ekorudiawan/KIWI-Final-Project/Dokumen KIWI FINAL/KIWI_FINAL_1.00.docx

[ KIWI FINAL AUTO PASTING NAMEPLATE USER & MAINTENANCE MANUAL]

# INDEX

# INTRODUCTION

The aim of this manual is to supply specification about the correct use of electrical drawing, schematic, flowchart and program.

# REFERENCE DATA

Costumer : SCHENEIDER ELECTRIC MANUFACTURING BATAM

Address : BATAMINDO INDUSTRIAL PARK LOT 4 MUKA KUNING

Machine Name : KIWI FINAL AUTO PASTING NAMEPLATE

Last Release : 1. Manual : KIWI_FINAL_1.00

2. Document Support : Electric_SCH

: Input_PLC

: Output_PLC

: Panel_Box

# WARNING FOR OPERATION SAFETY

The machine is equipped with automation test system. If there is any automation or spesific hardware make reference to the related chapter of this manual.

Don’t use product or machine programs different from the ones listed on Product Reference.

Don’t use machine if all parts have not been properly installed. See layout and schematic diagram inside this manual.

If you are doubt or disagree with the application, please press “Emergency Button” then report to maintenace.

# WARNING FOR MACHINE SAFETY

Before start the machine, please check all ecectrical supply and air supply is on. Wait until “Yellow Lamp” turn on. It’s indicate that machine ready to operate. If something problem, normally HMI panel will inform you what is the problem. But, if it’s not work, you can do this action.

- Push “Emergency Button” in HMI Panel Box.
- Red Lamp will be on, this indicate your machine is problem.
- Remove product from machine if product still on machine.
- Release “Emergency Button” and press “RESET Button” to reset emergency condition.
- Machine ready to operate again by pressing “START Button”
- If this action still not work, please turn off all electrical & air supply then restart the machine or you can report to project engineer or maintenance.

# WARNING FOR ADAPTER SAFETY

The main power input for the machine is single phase 220VAC. When installing the machine make sure that the terminal input power is installed corectly.

# 1. TEST APPLIACTION – OPERATE & USE

  1.1 START UP

After the installation for the incoming power ready with AC 220 V.

1. Switch on the main switch.
2. Switch on all MCB inside panel box.
3. Wait untill “YELLOW Lamp” or “RED Lamp” turn on.
4. Machine ready to use.
  1.2 OPERATE IN AUTOMATIC MODE

Normally automatic mode use for running product. To operate the machine with automatic mode follow this instruction.

1. Your machine already “START UP”, please follow intruction in point 1.1
2. Change “AUTO/MAN Button” to automatic position.
3. Press “START Button” to start machine in automatic mode.
4. “Green Lamp” will turn on, this indicate that your machine running in automatic mode.
5. Open KIWI Application, then scan reference of your product.
6. Insert the product to machine.
7. Nameplate will be print and pasting to product automatically.
8. Don’t put your hand inside the machine when machine still process to assembly or marking product.
9. To stop machine press “STOP Button”.
  1.3 OPERATE IN MANUAL MODE

Manual mode use for checking all condition of sensor and actuator works. With manual mode you can easy to find problem of machine if machine not works. Operate actuator one by one and then check sensor condition in HMI display. To operate in manual mode please follow this instruction.

1. Your machine already “START UP”, please follow intruction in point 1.1
2. Change “AUTO/MAN Button” to manual position.
3. Press “Manual Tab” in HMI panel.
4. To operate the cylinder or actuator you can press cylinder button one by one in HMI panel.
5. To monitor sensor and other input, you can press menu “I/O Monitor” in HMI panel.
  1.4 TROUBLESHOOTING

1.3.1 PLC

- PLC need supply 220 VAC and common 24V DC (if use PNP wiring), 0V DC (if use NPN wiring)
- Verify if mode operation of PLC is RUN mode.
- If PLC in STOP mode, please change to RUN with Serial cable and PLC software.
- If PLC in ERROR mode, please restartup the machine, refer to point 1.1

1.3.2 HMI Display

- HMI display need 24V DC supply, this supply connected to main power supply inside main panel machine. If HMI display not turn on, please check this connection cable.
- To communicate with PLC, HMI use ethernet cable. If HMI display not working or showing connection error in display, please check connection of this cable.

1.3.3 Sensor

Please see source document of sensor.

# 2. MACHINE APPLICATION – GENERAL INFORMATION

  2.1 Flowchart Machine Process

# 3. PROJECT DOCUMENT

  3.1 Sparepart

No | Main Panel
| Part Name | Spec | Qty | Used
1 | MCB | 2 pole 15A | 1 unit | Supply PLC
2 | MCB | 2 pole 15A | 1 unit | Supply I/O
3 | Switching PSU 24V | AVL8REM24050 | 1 unit | Supply CPU
4 | Switching PSU 5V | | 1 unit | Supply Rotary
5 | PLC | TWDLCAE40DRF | 1 unit | Controller
6 | Relay | RXM4B2BD | 1 unit | Electrical Safety
7 | Loto Switch | 24VDC | 1 unit | Panel Switch
8 | Power Lamp | XB5AVM4 | 3 unit | Power Indicator
9 | ELCB | 30mA | 1 unit | Electrical Safety

No | HMI Panel
| Part Name | Spec | Qty | Used
1 | Push Button Start | XB5AA31 | 1 pcs | Start Machine
2 | Push Button Stop | XB5AA42 | 1 pcs | Stop Machine
3 | Push Button Reset | XB5AW36B5 | 1 pcs | Reset Error
4 | Selector By Pass Emergency | XB5AW31B5 | 1 pcs | Enable/Disable Emergency
5 | Selector Switch Auto/Man | XB5AG41 | 1 pcs | Mode Operation
6 | Emergency Switch | XB5AS8444 | 1 pcs | Emergency
7 | HMI Display | 5 Inch HMI | 1 unit | Display Machine Condition

No | Banch
| Part Name | Spec | Qty | Used
1 | Tower Lamp | XVMB2RAGSHSB | 1 unit | Indicator Machine
2 | Solenoid | 24VDC | 2 unit | Drive Cylinder
3 | Sensor Cylinder | 24VDC | 4 pcs | Cylinder Sensor
4 | Sensor Product | 24VDC | 3 pcs | Product Sensor

  3.2 PLC I/O LIST
    3.2.1 INPUT

NO | PLC INPUT
| INPUT NAME | POSITION | LABELING
1 | EMERGENCY BUTTON | BANCH | %I0.0
2 | SENSOR_PRODUCT_5 | BANCH CONVEYOR | %I0.1
3 | SENSOR_PRODUCT_4 | BANCH CONVEYOR | %I0.2
4 | SELECTOR_STOPPER | BANCH CONVEYOR | %I0.3
5 | SENSOR A_MIN | BANCH | %I0.4
6 | SENSOR A_PLUS | BANCH | %I0.5
7 | SENSOR B_MIN | BANCH | %I0.6
8 | SENSOR B_PLUS | BANCH | %I0.7
9 | START | HMI PANEL | %I0.8
10 | FME (PRINTER) | BANCH | %I0.9
11 | EDG (PRINTER) | BANCH | %I0.10
12 | DB (PRINTER) | BANCH | %I0.11
13 | VWF (PRINTER) | BANCH | %I0.12
14 | SAA (PRINTER) | BANCH | %I0.13
15 | SENSOR_PRODUCT_1 | BANCH | %I0.14
16 | SENSOR_PRODUCT_2 | BANCH | %I0.15
17 | SENSOR_PRODUCT_3 | BANCH | %I0.16
18 | ROTARY_INIT_SENSOR | BANCH | %I0.18
19 | STOP | HMI PANEL | %I0.19
20 | RESET | HMI PANEL | %I0.20
21 | EMG BYPASS | HMI PANEL | %I0.21
23 | AUTO/MAN | HMI PANEL | %I0.22
23 | EMERGENCY | HMI PANEL | %I0.23

    3.2.2 OUTPUT

NO | PLC OUTPUT
| INPUT NAME | POSITION | LABELING
1 | STEP_ROTARY | BANCH | %Q0.0
2 | SOLENOID YC2 | BANCH CONVEYOR | %Q0.3
3 | SOLENOID YC1 | BANCH CONVEYOR | %Q0.4
4 | SOLENOID YA | BANCH | %Q0.5
5 | SOLENOID YB | BANCH | %Q0.6
6 | START_PRINTER | BANCH | %Q0.7
7 | DIR_ROTARY | BANCH | %Q0.8
8 | RED_TOWER_LAMP | BANCH | %Q0.10
9 | YELLOW_TOWER_LAMP | BANCH | %Q0.11
10 | GREEN_TOWER_LAMP | BANCH | %Q0.12
11 | RST_PRINTER | BANCH | %Q0.15

KIWI FINAL AUTO PASTING NAMEPLATEPage 13
