ekorudiawan/KIWI-Final-Project/Dokumen KIWI FINAL/Inpu_PLC.pdf

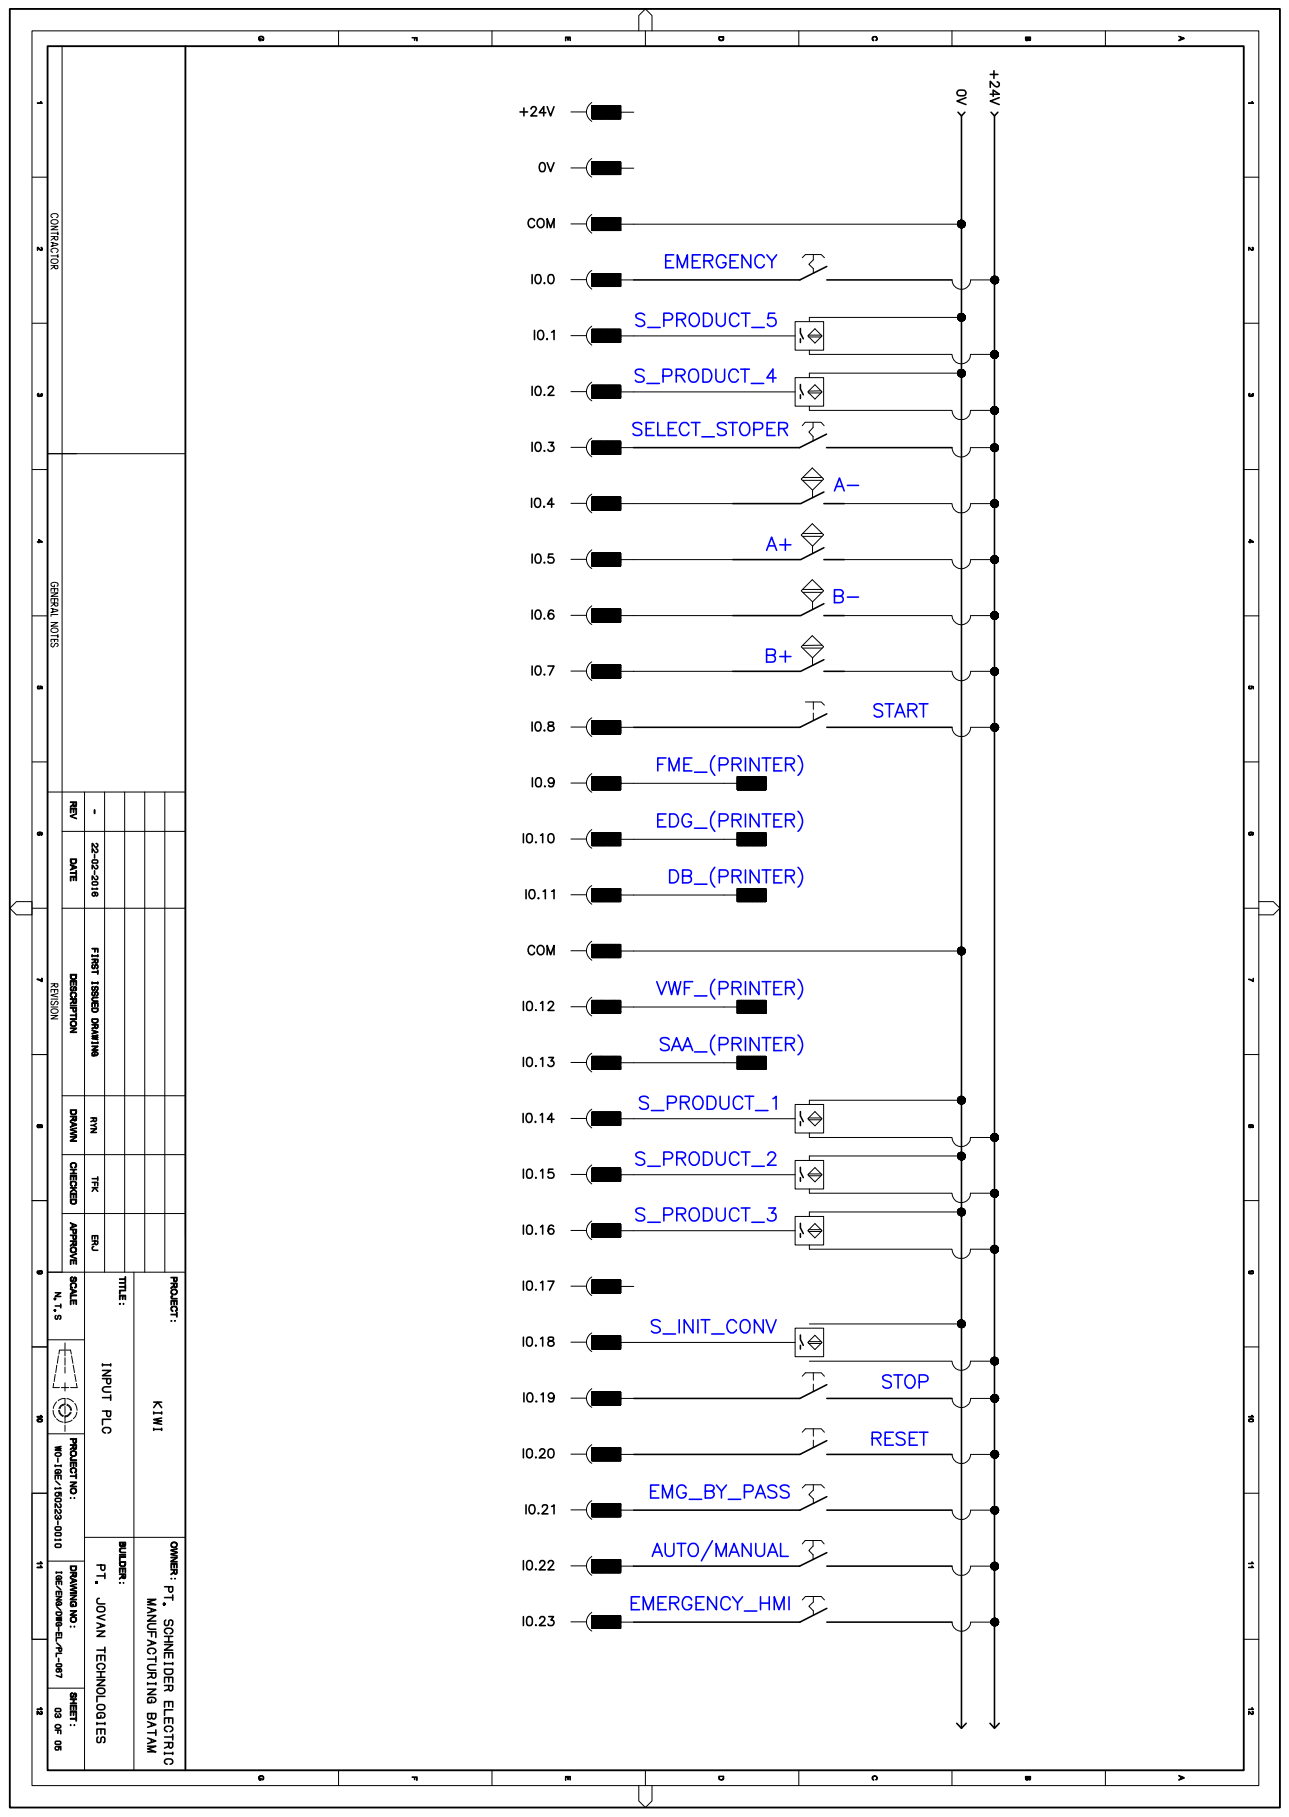
[picture p1: page 1]
