ekorudiawan/KIWI-Final-Project/Dokumen KIWI FINAL/Output_PLC.pdf

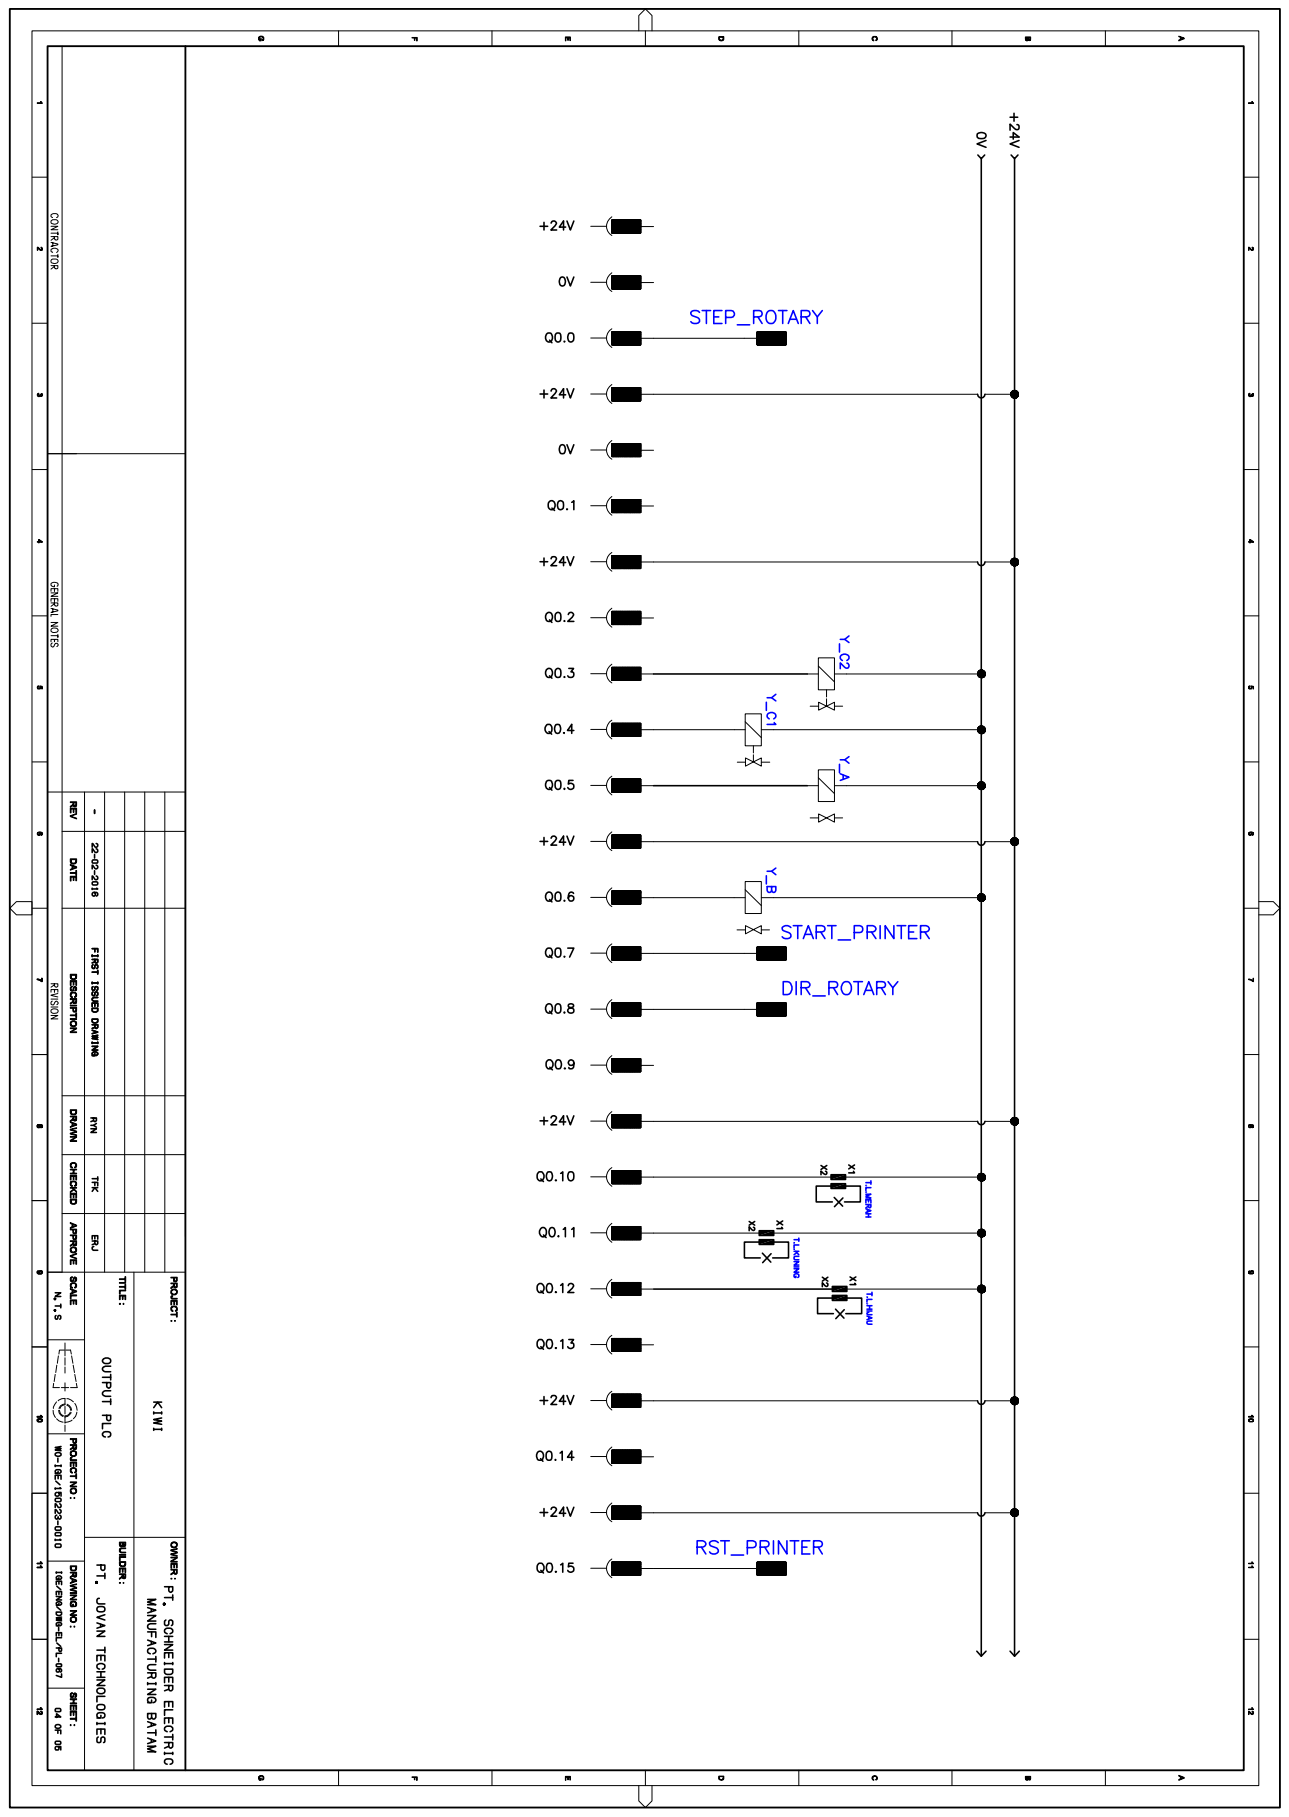
[picture p2: page 1]
