ekorudiawan/KIWI-Final-Project/Source Code/Source Code PLC KIWI FINAL/KIWI2_V1/thumbnail-dsc.bmp

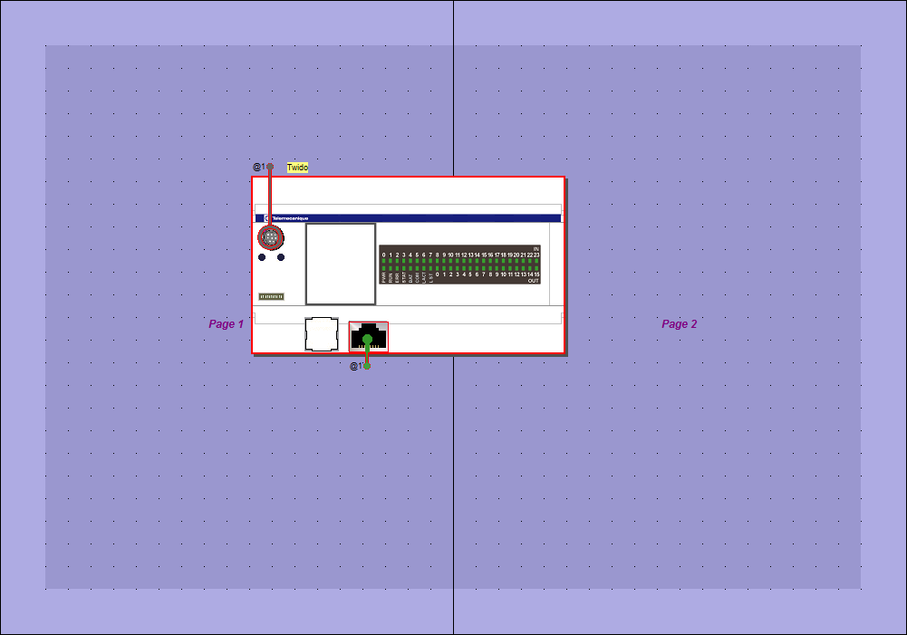
Source Code/Source Code PLC KIWI FINAL/KIWI2_V1/thumbnail-dsc.bmp
