ekorudiawan/KIWI-Final-Project/Dokumen KIWI FINAL/Schematic_Diagram.pdf

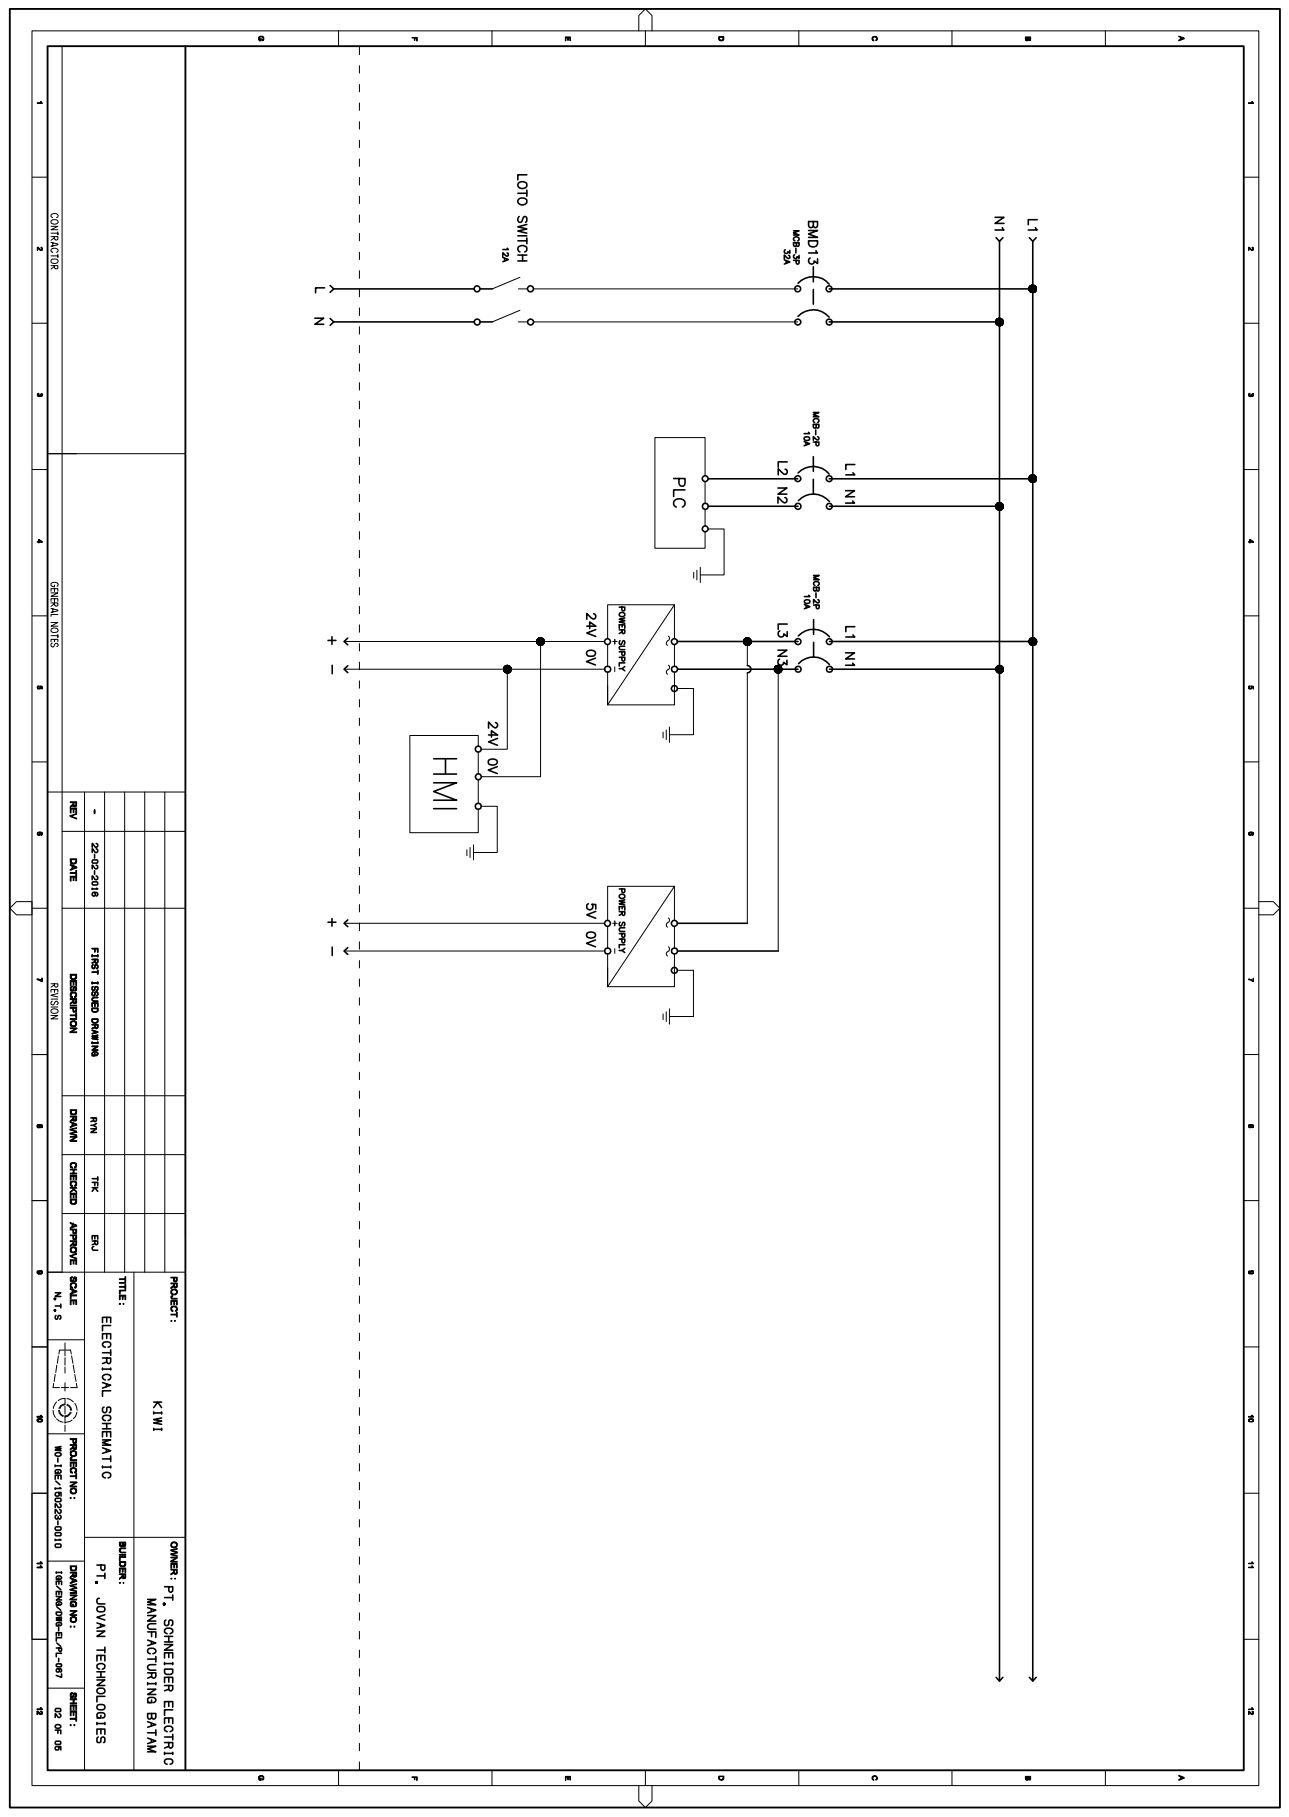
[picture p5: page 1]
