ekorudiawan/KIWI-Final-Project/Dokumen KIWI FINAL/Box_Panel.pdf

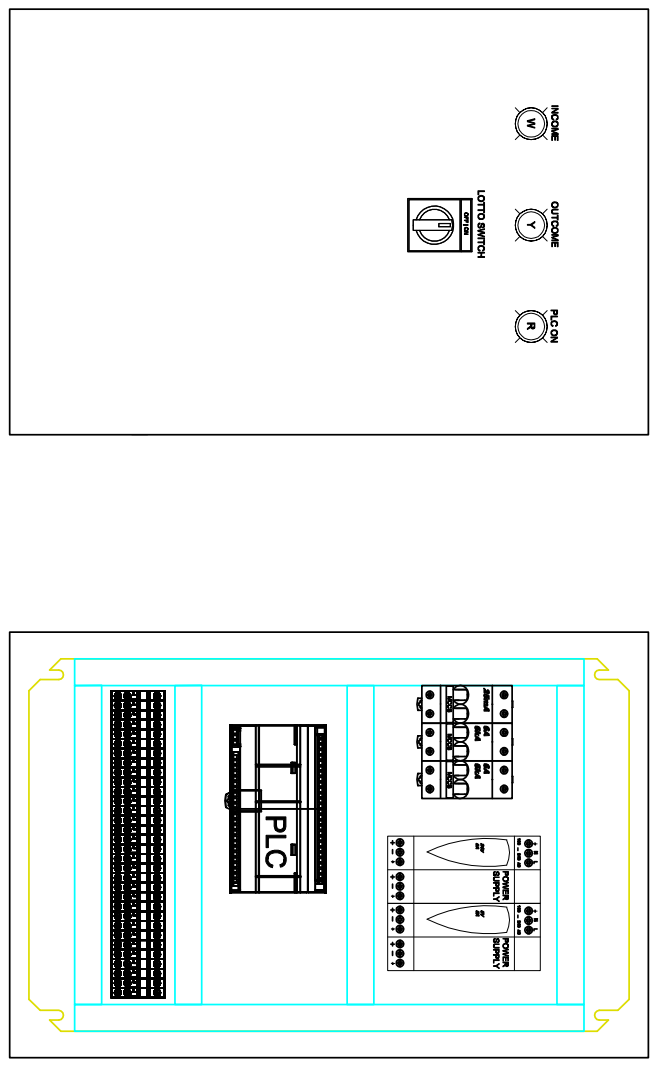
[picture p6: page 1]
