ekorudiawan/KIWI-Final-Project/Dokumen KIWI FINAL/Pneumatic_Diagram.pdf

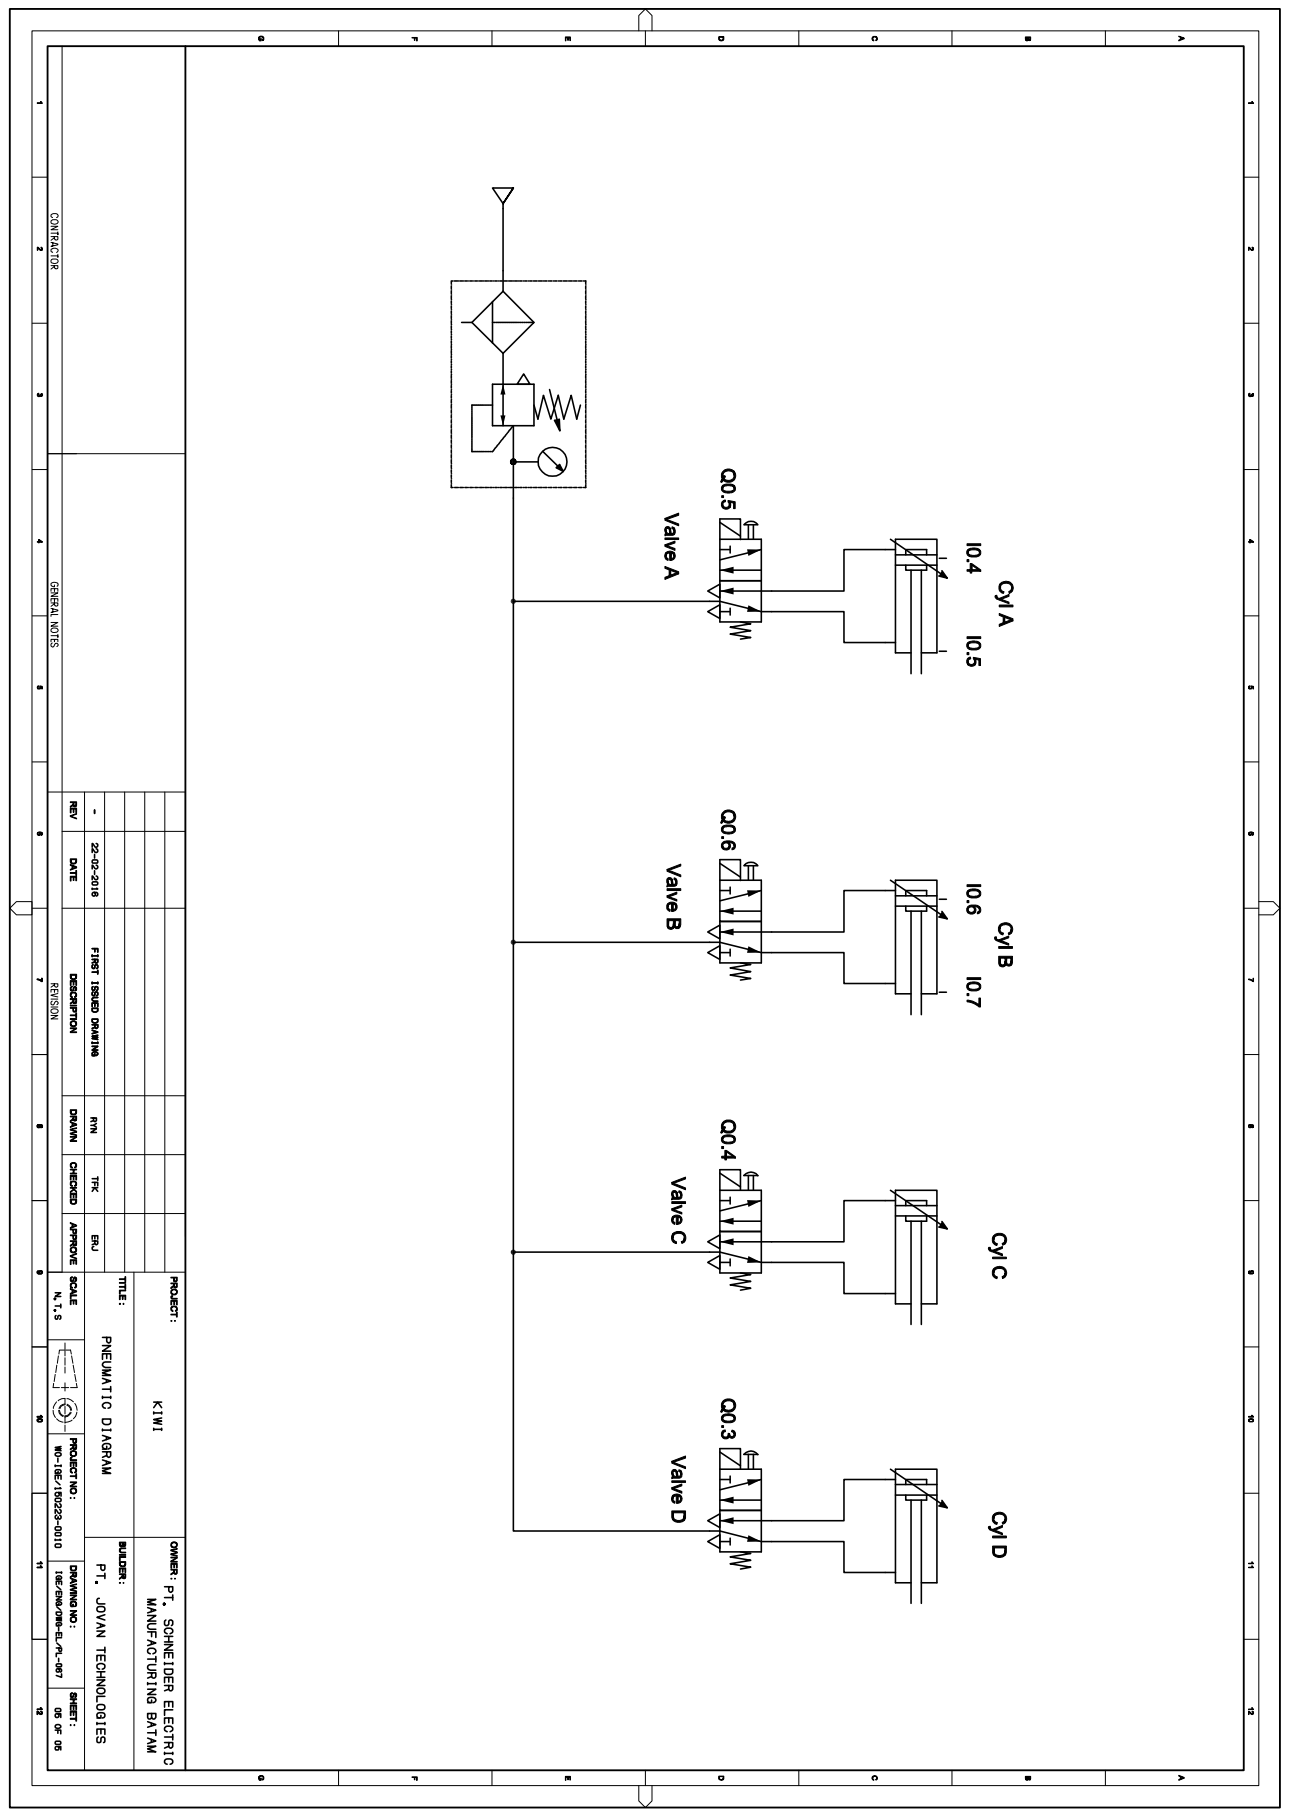
[picture p7: page 1]
