ekorudiawan/KIWI-Final-Project/Dokumen KIWI FINAL/Pneumatic Diagram.dxf

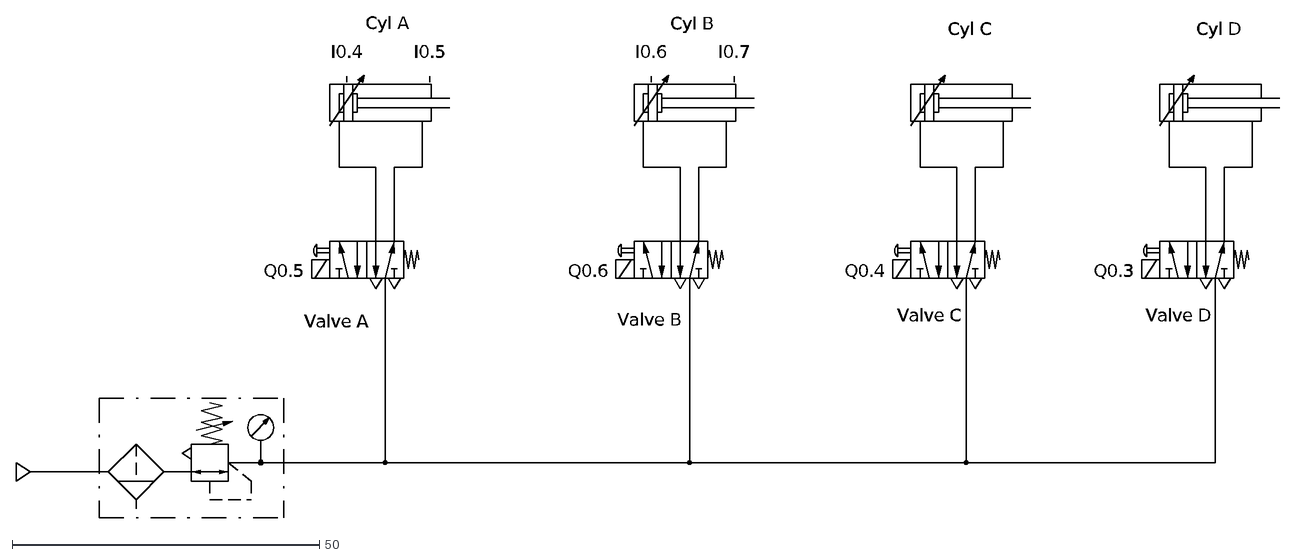
[picture p4: CAD file, 2016-10-16]
Dokumen KIWI FINAL/Pneumatic Diagram.dxf
Q0.5
Q0.6
I0.4
I0.5
I0.6
I0.7
Cyl A
Cyl B
Valve A
Valve B
Q0.4
Cyl C
Valve C
Q0.3
Cyl D
Valve D
