ekorudiawan/KIWI-Final-Project/(list of files, cad)

Other CAD files:
Dokumen KIWI FINAL/Box_Panel.dwg
Dokumen KIWI FINAL/Schematic_Diagram.dwg
Dokumen KIWI FINAL/Output_PLC.dwg
Dokumen KIWI FINAL/Input_PLC.dwg
Dokumen KIWI FINAL/Pneumatic_Diagram.dwg
